eltonfernando/Extensometria/README.md

# Extensometria
Uma ferramenta embarcada para Análise de deformação em estrutura metálica.
