eltonfernando/Extensometria/Artigo_extensometro-07.pdf

Instrumentaçao Eletr ˜ | onica Aplicada a An ˆ | alise de ´
Deformaçao em Estruturas Met ˜ | alicas ´

1Elton Fernandes dos Santos
Curso de Engenharia Eletrica, FACET ´ UNEMAT, Sinop, Brasil
eltonfernando90@gmail.com

2Vlademir de Jesus Silva Oliveira
Curso de Engenharia Eletrica, FACET ´ UNEMAT, Sinop, Brasil
vlademir.oliveira@unemat.br

3Wagner de Almeida Ferreira
Curso de Engenharia Civil, FACET UNEMAT, Sinop, Brasil
wagnervt.almeida@gmail.com

4
Julio Cesar Beltrame Benatti ´
Curso de Engenharia Civil, FACET UNEMAT, Sinop, Brasil
benatti@unemat.br

Resumo—Este trabalho concentra-se no estudo de um modulo ´
de aquisiçao de dados para realizar ensaios de deformaç ˜ | ao em ˜
barras metalicas utilizando extensometria. O sistema consiste em ´ um circuito de condicionamento de sinal compatível com a plataforma Arduino, onde, os dados coletados podem ser processados e armazenados. Ao longo desse trabalho foram abordadas as etapas
de condicionamento de sinal como, amplificaçao e convers ˜ | aõ
analogica-digital. ´
O modelo proposto foi submetido a ensaios de prova de carga utilizando barra de aço CA 50, pois a mesma e amplamente ´ utilizada em construçao civil. Posteriormente foi realizado ensaio ˜ com treliça, no qual alguns sensores foram colocados em locais
estrategicos para medir os pontos onde se esperava as m ´ | aximas ´
deformaçoes. Os resultados obtidos apresentaram coer ˜ | encia ao ˆ
compara-los com simulaç ´ | ao realizada no software Ftool. ˜
Index Terms—Amplificador de instrumentaçao, Ardu ˜ | íno, ex-
tensometro, prova de carga ˆ
I. INTRODUÇ AÕ

O dimensionamento de um projeto estrutural realizado com base em estimativas pode alocar parte dos recursos de forma ineficiente, pois a estrutura adequada depende de
varios fatores. A extensometria, que ´ | e a t ´ | ecnica utilizada ´
para a analise experimental de tens ´ | oes e deformaç ˜ | oes em ˜
estruturas mecanicas, pode ser utilizada para esse fim. Embora ˆ existam outros metodos, o uso de strain-gauge (medidor de ´
deformaçao) ˜ | e um dos mais vers ´ | ateis. Este trabalho apresenta ´
um modelo para processamento de sinal utilizando extensometria, no qual foi implementado em um modulo shield ´ compatível com a plataforma Arduíno e realizado um ensaio de prova de carga com barra metalica CA 50 utilizada em ´ estruturas de concretos.

II. DESENVOLVIMENTO

A. strain-gauge
A preparaçao da superf ˜ | ície e colagem do extensometro ˆ
constitui-se numa etapa de grande importancia, por isso deve- ˆ se verificar atentamente todas as recomendaçoes dos fabri- ˜ cantes. Se essa etapa for conduzida de forma impropria, ´
os resultados serao comprometidos [1]. O objetivo ˜ | e que o ´
extensometro reproduza fielmente as micro-deformaç ˆ | oes, para ˜

isso a superfície dever ser uniforme e devidamente preparada, como na Figura 1.

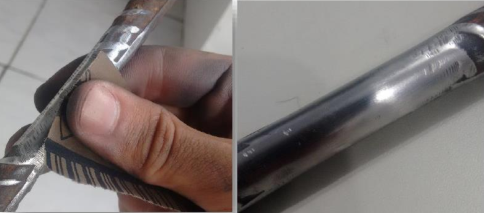
[picture p1: figure]

Figura 1. Preparo da superfície.

A fixaçao pode ser feita com Cianoacrilato, vale lembra, ˜ que a superfície deve estar livre de impurezas, para isso pode-se utilizar acetona. O procedimento de colagem pode
variar dependendo da aplicaçao, por ˜ | em para corpos met ´ | alicos ´
o procedimento descrito acima e valido. ´
O extensometro ˆ | e projetado para medir somente as ´
deformaçoes longitudinais da grade. Por essa raz ˜ | aõ | e im- ´
portante identificar previamente a direçao das deformaç ˜ | oes ˜
que deseja medir. Porem para mediç ´ | oes espec ˜ | íficas existem
combinaçoes de extens ˜ | ometros angularmente dispostos que ˆ
permite realizar mediçao em v ˜ | arias direç ´ | oes. ˜
O tamanho e determinado pela caracter ´ | ística do material
usado no ensaio, em materiais heterogeneos requer-se uma ˆ
area maior para que a variaç ´ | ao de resist ˜ | encia seja represen- ˆ
tativa. A escolha do sensor adequado tambem depende das ´
condiçoes que o afetam durante o processo, as informaç ˜ | oes ˜
mais relevantes sao expressas em c ˜ | odigo, que combinados ´
formam o nome do sensor [2]. O modelo utilizado foi, BF-350-3-AA.
- BF: características referente ao material de fabricaçao do ˜ sensor.
- 350: Resistencia ˆ ohmica. ˆ
- 3-AA: característica geometrica. ´
Os extensometros apresentam sensibilidade a temperatura, ˆ
portanto, dependendo da aplicaçao, deve utilizar m ˜ | etodos de ´
compensaçao. ˜

B. Condicionamento de sinal
A ponte de Wheatstone e empregada em muitas aplicaç ´ | oes, ˜
principalmente em mediçoes de pequenos sinais. Uma ponte ˜ pode ser composta por quatro componentes, entre resistores e sensores. Da-se o nome de um quarto, meia ou ponte completa, ´
quando os resistores sao substitu ˜ | ídos respectivamente por um,
dois, ou quatro sensores. Na Figura 2 apresenta-se uma ponte em um quarto.

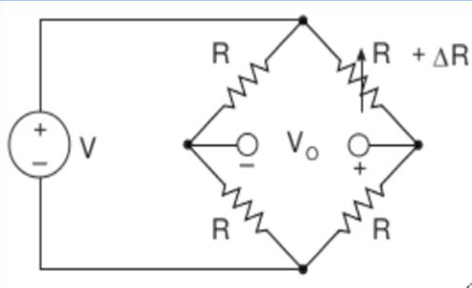
[picture p2: figure]

Figura 2. Ligaçao de ˜ 1/4 de ponte.

Considerando que os resistores sejam iguais e ideais e que o sensor tenha uma variaçaõ ∆R, a diferença de potencial Vo pode ser calculada usando o conceito de divisor de tensao, ˜ resultando nas equaçoes (1) e (2). ˜

Vo− =

V R
2R
=

V
2

(1)

Vo+ =

V R
2R + ∆R
=
V

2 + ∆R/R
(2)
A saída Vo e dada pela diferença das equaç ´ | oes (2) e (1) ˜

Vo = −

V
2
∆R/R

2 + ∆R/R
(3)

Os amplificadores operacionais podem ser ajustados de acordo com as necessidades do projetista, isso os habilita para
uma gama ampla de aplicaçoes [3]. Uma das configuraç ˜ | oes ˜
mais utilizada em instrumentaçao, ˜ | e o ampliador de diferença, ´
visto na Figura 3.

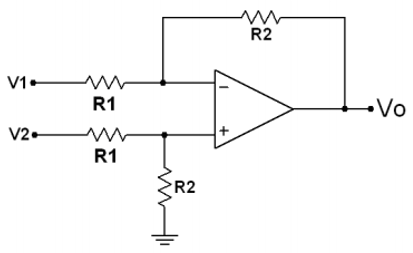
[picture p3: figure]

Figura 3. Configuraçao amplificador de diferença. ˜

A saída do circuito e resultado da diferença das entradas ´ multiplicado por um ganho, como apresentado na equaçao (8). ˜

V+ =

V2R2
R1 + R2

(4)

V1 − V+
R1

=

V+ − Vo
R2

(5)

Vo = −

V1R2
R1

+ V+

R2
R1

+ 1
(6)
Substituindo equaçao (4) na equaç ˜ | ao (6). ˜

Vo = −

V1R2
R1

+

| V2R2 R1 + R2

R2 + R1
R1
(7)

Vo =

R2
R1
(V2 − V1) | (8)

Supondo que as entras V1 e V2 estejam sujeitas ao sinal
de ruído, a tendencia ˆ | e que esse sinal indesejado seja ampli- ´
ficado na saída, porem esse circuito possui uma caracter ´ | ística
chamada de razao de rejeiç ˜ | ao de modo comum (CMRR, ˜
common-mode rejection ratio), que e a capacidade de atenuar ´ sinais identicos nas entradas [3]. Dessa forma, o amplificador ˆ de diferença, usando resistores de precisao, amplifica apenas ˜ sinais diferenciais vindo da entrada.
O circuito projetado e a ligaç ´ | ao de um amplificador di- ˜
ferencial aos polos da ponte, com acoplamento de um potenciometro para ajuste. No caso da Figura 4 um dos resistores ˆ da ponte deve ser substituído pelo sensor.

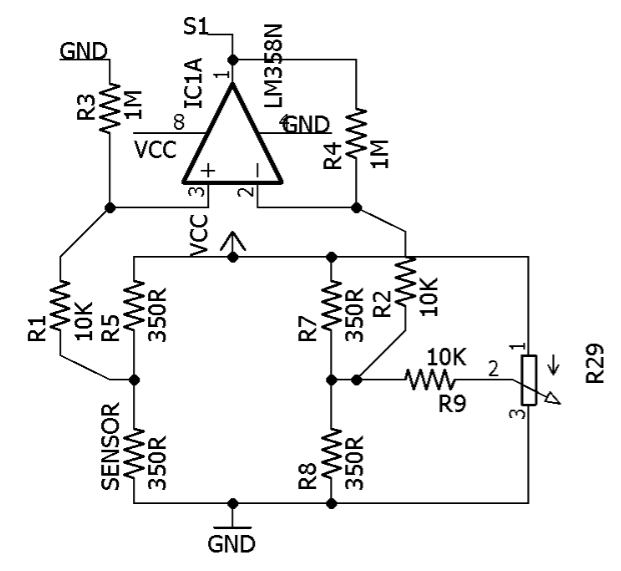
[picture p4: figure]

Figura 4. Circuito para condicionamento de sinal do sensor.

O ganho do amplificador deve ser ajustado de acordo com
a aplicaçao. Embora seja poss ˜ | ível determinar um ganho por
metodos te ´ | orico, o mesmo pode n ´ | ao ser satisfat ˜ | orio e como ´
geralmente os ensaios sao destrutivos, conv ˜ | em realizar um ´
procedimento de calibraçao, para isso dever ser utilizado uma ˜ prensa com medidor de carga, como na Figura 5.
A fim de evitar escorregamento, pode ser colocado algumas folhas de papel entre a barra e a mesa da prensa, o
procedimento de calibraçao deve ser realizado at ˜ | e atingir carga ´
maxima que ser ´ | a usada no ensaio de prova de carga. ´
C. Processamento de sinal
O processo de conversao anal ˜ | ogico-digital consiste em obter ´
uma parcela do sinal analogico e represent ´ | a-lo na forma digi- ´
tal. Embora quase toda informaçao possa ser representada no ˜ domínio digital, existem alguns fatores limitantes. O Arduíno

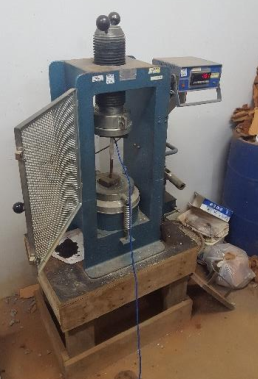
[picture p5: figure]

Figura 5. prensa hidraulica usada nos ensaios. ´

possui um conversor A/D integrado de 10bits, ou seja, em
uma escala de 0 a 5 volts serao representadas ˜ | | 1024 posiçoes, ˜
portanto o menor valor de tensao que pode ser lido ˜ | | e de ´
5/1024,(4.9mV ), a tensao de refer ˜ | encia poder ser alterada ˆ
para valores menores que 5V , porem o range diminui [4]. ´
Outro fator e decorrente do processo de quantizaç ´ | | ao, segundo ˜
[4] ha um erro absoluto de ´

1/2 LSB nesse caso, 4.9mV /2 = 2.45mV . A frequencia de amostragem fica sujeita ao tempo de ˆ
resposta da funçao analogRead(), que ˜ | e cerca de ´ | 100us, porem´
essa e uma particularidade da plataforma Arduino onde o fator ´
de divisao do prescaler ˜ | e definido como 128, o prescaler pode ´
ser reconfigurado alterando os 3 primeiros bits do registrado ADCSRA atraves de ferramentas nativas do microcontrolador ´ AVR [5].
Para o armazenamento no cartao SD, foi utilizado a bibli- ˜ oteca SD.h e criado um arquivo .txt, onde os dados foram organizados em colunas e posteriormente importados para o Excel®.

III. RESULTADOS

O sistema tem uma placa com suporte para ate 3 sensores ´
simultaneos, os pinos de sa ˆ | ídas S1, S2 e S3, na Figura 7 devem
ser ligadas aos pinos analogico do Arduino. ´
O algorítimo desenvolvido para coleta dos dados e mostrado ´ no fluxograma na Figura 6.

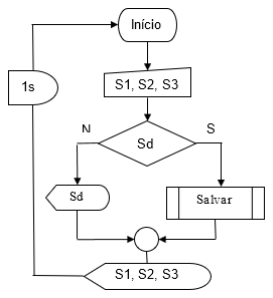
[picture p6: figure]

Figura 6. Fluxograma.

No modulo foi utilizado o CI LM358 com capacitores de ´
desacoplamento ligados as fontes e resistores com toler ` | ancia ˆ
de 1%. A Figura 7 apresenta o circuito impresso.

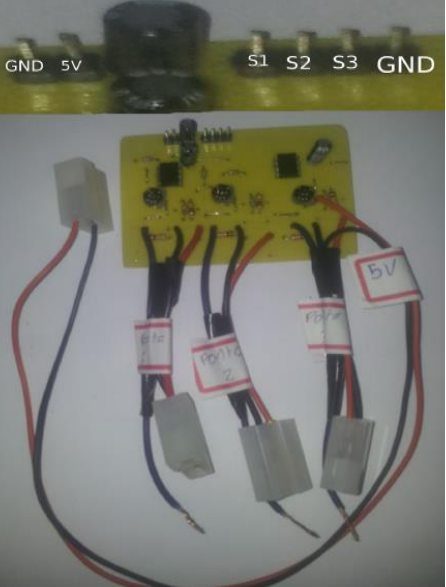
[picture p7: figure]

Figura 7. Circuito impresso.

Na Figura 8 e apresentado o gr ´ | afico da tens ´ | ao el ˜ | etrica por ´
deformaçao do ensaio realizado com carga m ˜ | axima de ´ | 56KN.

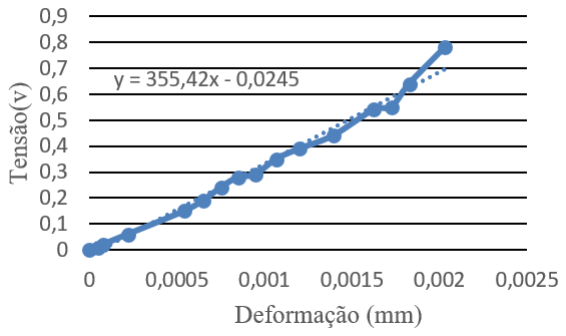
[picture p8: figure]

Figura 8. Deformaçao por tens ˜ | ao. ˜
A tensao de saturaç ˜ | ao do amplificador depende da carga, ˜
nesse caso a saturaçao ocorreu em ˜ | 0V e 3, 5V . Assim o range
de tensao mostrada no gr ˜ | afico da Figura (8) ´ | (0V a 0, 8V )
pode ser aumentado, para isso basta determinar um novo ganho utilizando a equaçao (9). ˜
| G =

3, 5(100)
0, 8
= 437, 5 | (9)
Onde 3, 5 e a tens ´ | ao de saturaç ˜ | ao, 100 o ganho do amplificador ˜
e 0, 8 o range alcançado no ensaio.
Para assegurar que o amplificador nao opere em saturaç ˜ | aõ
convem arredondar os valores de ganho sempre para baixo. ´ Portanto para realizar um ensaio utilizando barra CA 50,
contando que, a carga nao ultrapasse ˜ | 56KN, o modelo apre-
sentado comporta esse ensaio.
O modulo desenvolvido nesse trabalho foi utilizado para ´ realizar dois ensaios, pouco pode se dizer do primeiro ensaio, descrito no artigo de [6], a carga maxima aplicada foi dis- ´ tribuída entre a barra e a estrutura de concreto que a envolvia, portanto, o ganho do amplificador foi mal dimensionado, necessitando de outro aparelho para aferir a mediçao. J ˜ a no ´

trabalho de [7] sabia-se, exatamente qual força seria aplicado a estrutura, o ensaio foi realizado colocando 3 sensores em uma treliça e comparado os resultados obtidos com simulaçaõ no software Ftool. Segundo o autor, ao considerar um modelo ideal da estrutura, os resultados nao foi coerente, portanto ao ˜ inserir as excentricidades e o momento fletor, os resultados
foram bem proximos das mediç ´ | oes, ou seja, utilizar modelos ˜
ideais nem sempre pode ser a melhor opçao. ˜

IV. CONCLUSAÕ

Os resultados obtidos foram satisfatorios, apresentando pre- ´
cisao consider ˜ | avel e praticidades ao realizar as mediç ´ | oes. Os ˜
potenciometros acoplados a ponte de Wheatstone permitem ˆ
ajustar o valor de medida inicial, assim e poss ´ | ível realizar
mediçoes em ensaios de traç ˜ | ao (escala crescente) ou de ˜
compreensao (escala decrescente), fazendo apenas alteraç ˜ | aõ
no valor inicial das mediçoes, com o ajuste do potenci ˜ | ometro. ˆ
Com o amplificador de diferença foi possível ajustar o sinal para a entrada do conversor A/D, porem dependendo ´ do ensaio, pode ser necessario reajustar o ganho. Embora ´
a resoluçao utilizada permitisse, n ˜ | ao foi poss ˜ | ível usar uma
precisao com mais de ˜ | 2 casas decimais, pois forças residuais
internas ao corpo de prova provocam instabilidade, causando
oscilaçoes na sa ˜ | ída. Configuraçao de “ ˜ | 1/2“ ponte utilizando
extensometro de ˆ | 90◦
, ajuda inibir os efeitos das forças residuais internas, possibilitando uma mediçao mais precisa caso ˜ seja necessario. ´

AGRADECIMENTOS
Os autores sao gratos ao Mestre Maicon Jos ˜ | e Hillesheim ´
por auxiliar nos ensaios realizados.

REFERENCIAS ˆ

[1] Excel sensores. preparaçao da superf ˜ | ície e colagem do extensometro na ˆ
peça. 1.ed. Sao paulo, 2004,4p. modelo- Manual de instruç ˜ | aõ
[2] AGS-TECH,Coding | System | of | Strain | Gau-
ges, | Albuquerque | novo | Mexico. | In: ´
https://www.elecrow.com/wiki/images/4/48/Coding System of Strain Gauges-AGS-TECH Version.pdf(acessado em 15 de Outubro de 2017)
[3] A. J., PERTENCE, Eletronica anal ˆ | ogica: Amplificadores operacionais e ´
filtros ativos: 6 ed. Rio de Janeiro,Bookman, 2007.
[4] ATMEL, AVR120: Characterization and Calibration of the ADC on an AVR, application note. In: http://www.atmel.com/Images/Atmel-2559-Characterization-and-Calibration-of-the-ADC-on-an-AVR ApplicationNote AVR120.pdf(acessado em 15 de Novembro de 2017)
[5] ATMEL, Atmel 8-bit microcontroller with 4/8/16/32KBYTES in-system programmable flash, datasheet. In: http://www.atmel.com/images/Atmel-8271-8-bit-AVR-Microcontroller-ATmega48A-48PA-88A-88PA-
168A-168PA-328-328P datasheet Complete.pdf(acessado | em | 15
de Novembro de 2017)
[6] W. A., Ferreira, J. C. B. Benatti,Analise do comportamento de estaca ´ escavada, instrumentada, em solo da regiao de Sinop/MT. 2017. 9p. ˜ Monografia (engenharia Civil)- UNEMAT, universidade do estado do Mato Grosso, Sinop.
[7] M. H. Batelo, M. J. Hillesheim, Analise experimental da capacidade ´ resistente de uma treliça metalica composta por perfis formados a ´ frio.2017. 9p. Monografia (engenharia Civil)- UNEMAT, universidade do estado do Mato Grosso, Sinop.
[8] NBR 14762, Dimensionamento de estruturas de aço constituídas por perfis formados a frio. Rio de Janeiro, 2010.
[9] GRANTE, Apostila de extensometria. Universidade Federal de Santa Catarina, Florianopolis, 2004. ´
